matthijahn/8BitComputer/README.md

# 8BitComputer

This projects aims to build an 8-bit computer for educational purpurses

you will find the files for the seperate componst as KiCad filles as well as simulation data for each component

I want to implement an own machinecode and an asambler
