matthijahn/8BitComputer/InstructionRegister/InstructionRegister.kicad_pcb

## KiCad design InstructionRegister/InstructionRegister.kicad_pcb (2023-03-05)

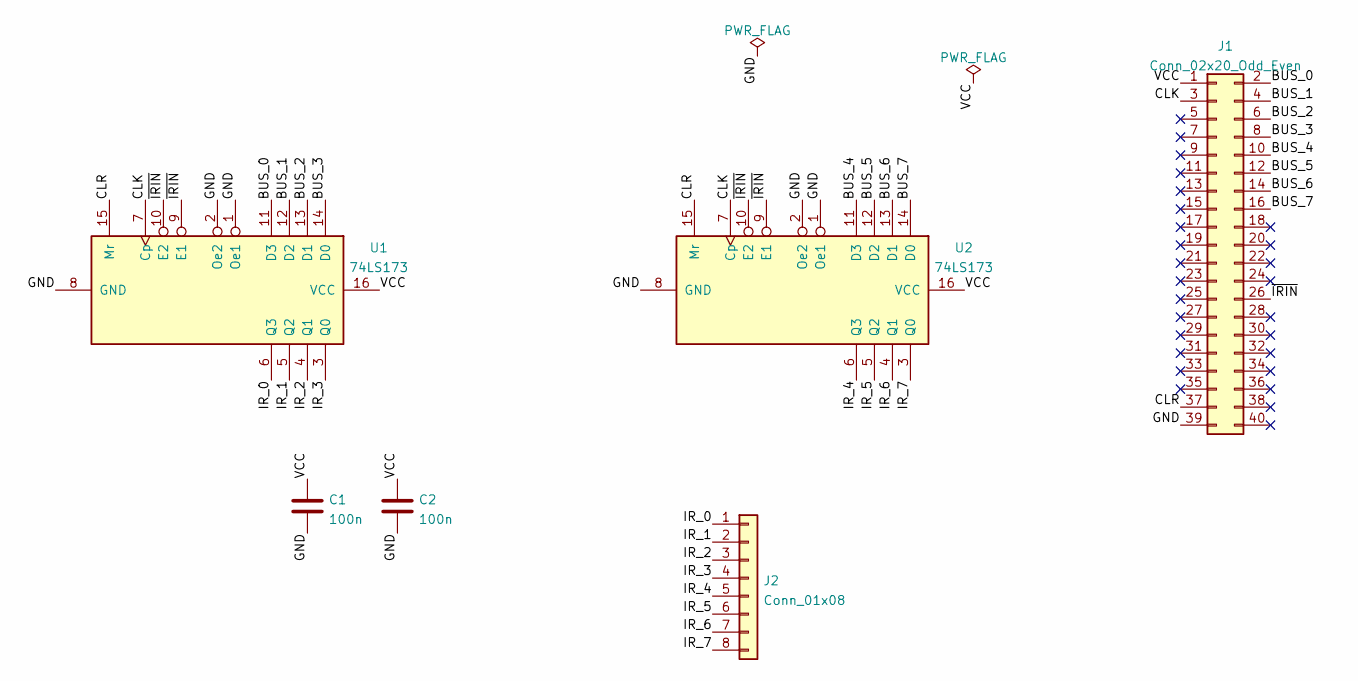
[picture p1: schematic InstructionRegister.kicad_sch]

Parts:
C1, C2: 100n; C_Disc_D5.0mm_W2.5mm_P5.00mm
J1: Conn_02x20_Odd_Even; PinSocket_2x20_P2.54mm_Horizontal
J2: Conn_01x08; PinHeader_1x08_P2.54mm_Horizontal
U1, U2: 74LS173; DIP-16_W7.62mm_LongPads

Connections:
/BUS_0: J1.2, U1.11 (D3)
/BUS_1: J1.4, U1.12 (D2)
/BUS_2: J1.6, U1.13 (D1)
/BUS_3: J1.8, U1.14 (D0)
/BUS_4: J1.10, U2.11 (D3)
/BUS_5: J1.12, U2.12 (D2)
/BUS_6: J1.14, U2.13 (D1)
/BUS_7: J1.16, U2.14 (D0)
/CLK: J1.3, U1.7 (Cp), U2.7 (Cp)
/CLR: J1.37, U1.15 (Mr), U2.15 (Mr)
/GND: C1.2, C2.2, J1.39, U1.1 (Oe1), U1.2 (Oe2), U1.8 (GND), U2.1 (Oe1), U2.2 (Oe2), U2.8 (GND)
/IR_0: J2.1, U1.6 (Q3)
/IR_1: J2.2, U1.5 (Q2)
/IR_2: J2.3, U1.4 (Q1)
/IR_3: J2.4, U1.3 (Q0)
/IR_4: J2.5, U2.6 (Q3)
/IR_5: J2.6, U2.5 (Q2)
/IR_6: J2.7, U2.4 (Q1)
/IR_7: J2.8, U2.3 (Q0)
/VCC: C1.1, C2.1, J1.1, U1.16 (VCC), U2.16 (VCC)
/~IRIN: J1.26, U1.9 (E1), U1.10 (E2), U2.9 (E1), U2.10 (E2)

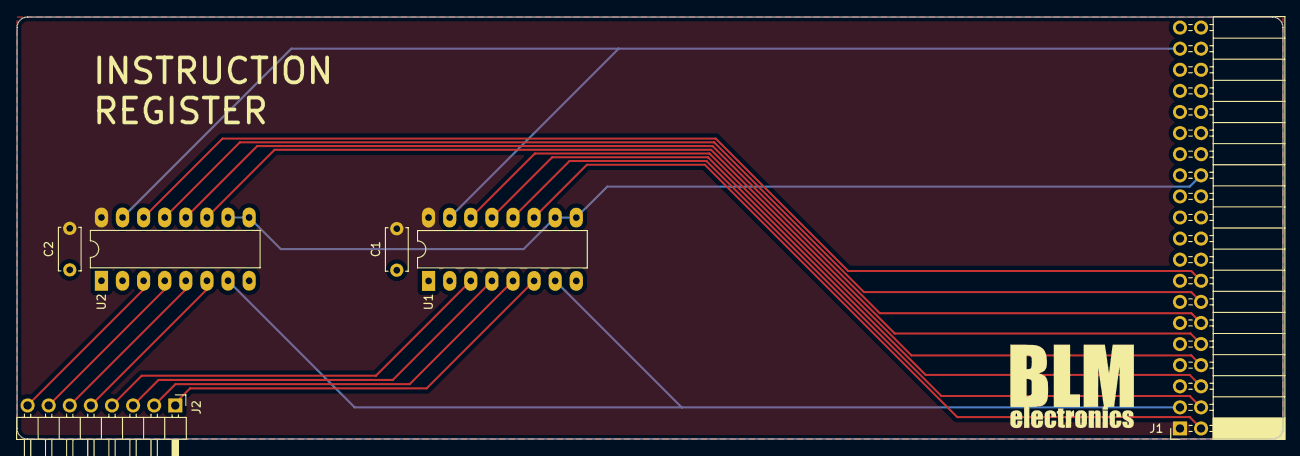
[picture p2: board InstructionRegister.kicad_pcb from above]

Board: 2 copper layers, 152.4 x 50.8 mm, 6 parts (0 on the bottom side), 21 nets.
