matthijahn/8BitComputer/PC/ProgrammCounter.kicad_pcb

## KiCad design PC/ProgrammCounter.kicad_pcb (2023-03-05)

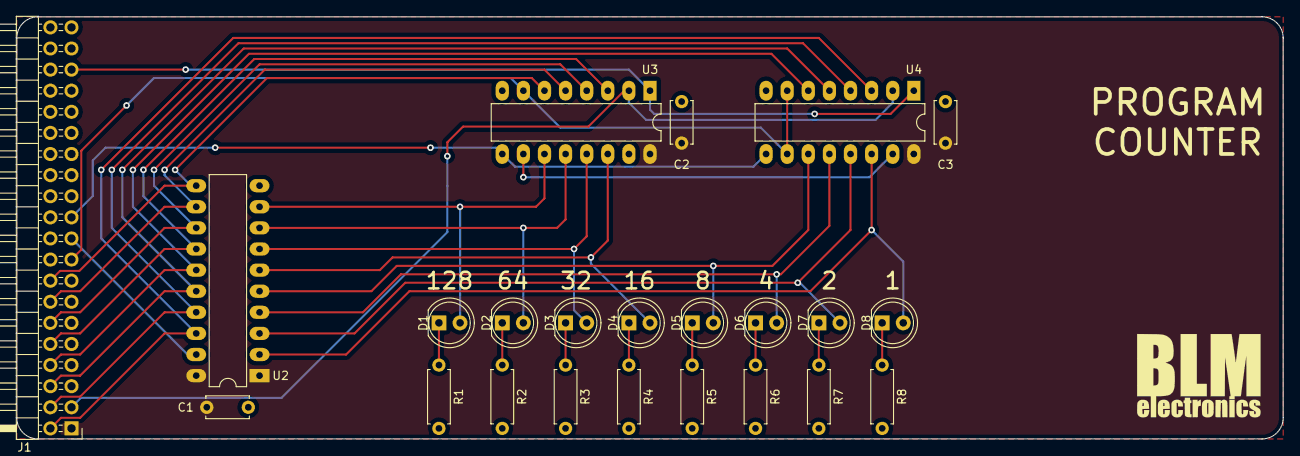
[picture p3: board ProgrammCounter.kicad_pcb from above]

Board: 2 copper layers, 152.4 x 50.8 mm, 23 parts (0 on the bottom side), 32 nets.

Parts:
C1, C2, C3: 100n; C_Disc_D5.0mm_W2.5mm_P5.00mm
D1, D2, D3, D4, D5, D6, D7, D8: LED; LED_D5.0mm
J1: Conn_02x20_Odd_Even; PinHeader_2x20_P2.54mm_Horizontal
R1, R2, R3, R4, R5, R6, R7, R8: R; R_Axial_DIN0207_L6.3mm_D2.5mm_P7.62mm_Horizontal
U2: 74HC245; DIP-20_W7.62mm_LongPads
U3, U4: 74LS161; DIP-16_W7.62mm_LongPads

Connections:
/BUS_0: J1.2, U2.18, U4.3
/BUS_1: J1.4, U2.17, U4.4
/BUS_2: J1.6, U2.16, U4.5
/BUS_3: J1.8, U2.15, U4.6
/BUS_4: J1.10, U2.14, U3.3
/BUS_5: J1.12, U2.13, U3.4
/BUS_6: J1.14, U2.12, U3.5
/BUS_7: J1.16, U2.11, U3.6
/CLK: J1.3, U3.2, U4.2
/GND: C1.2, C2.2, C3.2, J1.39, R1.2, R2.2, R3.2, R4.2, R5.2, R6.2, R7.2, R8.2, U2.10, U3.8, U4.8
/PCUP: J1.17, U3.7, U4.7, U4.10
/VCC: C1.1, C2.1, C3.1, J1.1, U2.1, U2.20, U3.16, U4.16
/~CLR: J1.35, U3.1, U4.1
/~PCIN: J1.21, U3.9, U4.9
/~PCOUT: J1.19, U2.19
unnamed: D1.1, R1.1
unnamed: D1.2, U2.9, U3.11
unnamed: D2.1, R2.1
unnamed: D2.2, U2.8, U3.12
unnamed: D3.1, R3.1
unnamed: D3.2, U2.7, U3.13
unnamed: D4.1, R4.1
unnamed: D4.2, U2.6, U3.14
unnamed: D5.1, R5.1
unnamed: D5.2, U2.5, U4.11
unnamed: D6.1, R6.1
unnamed: D6.2, U2.4, U4.12
unnamed: D7.1, R7.1
unnamed: D7.2, U2.3, U4.13
unnamed: D8.1, R8.1
unnamed: D8.2, U2.2, U4.14
unnamed: U3.10, U4.15
