matthijahn/8BitComputer/BUS/bus.kicad_pcb

## KiCad design BUS/bus.kicad_pcb (2023-03-05)

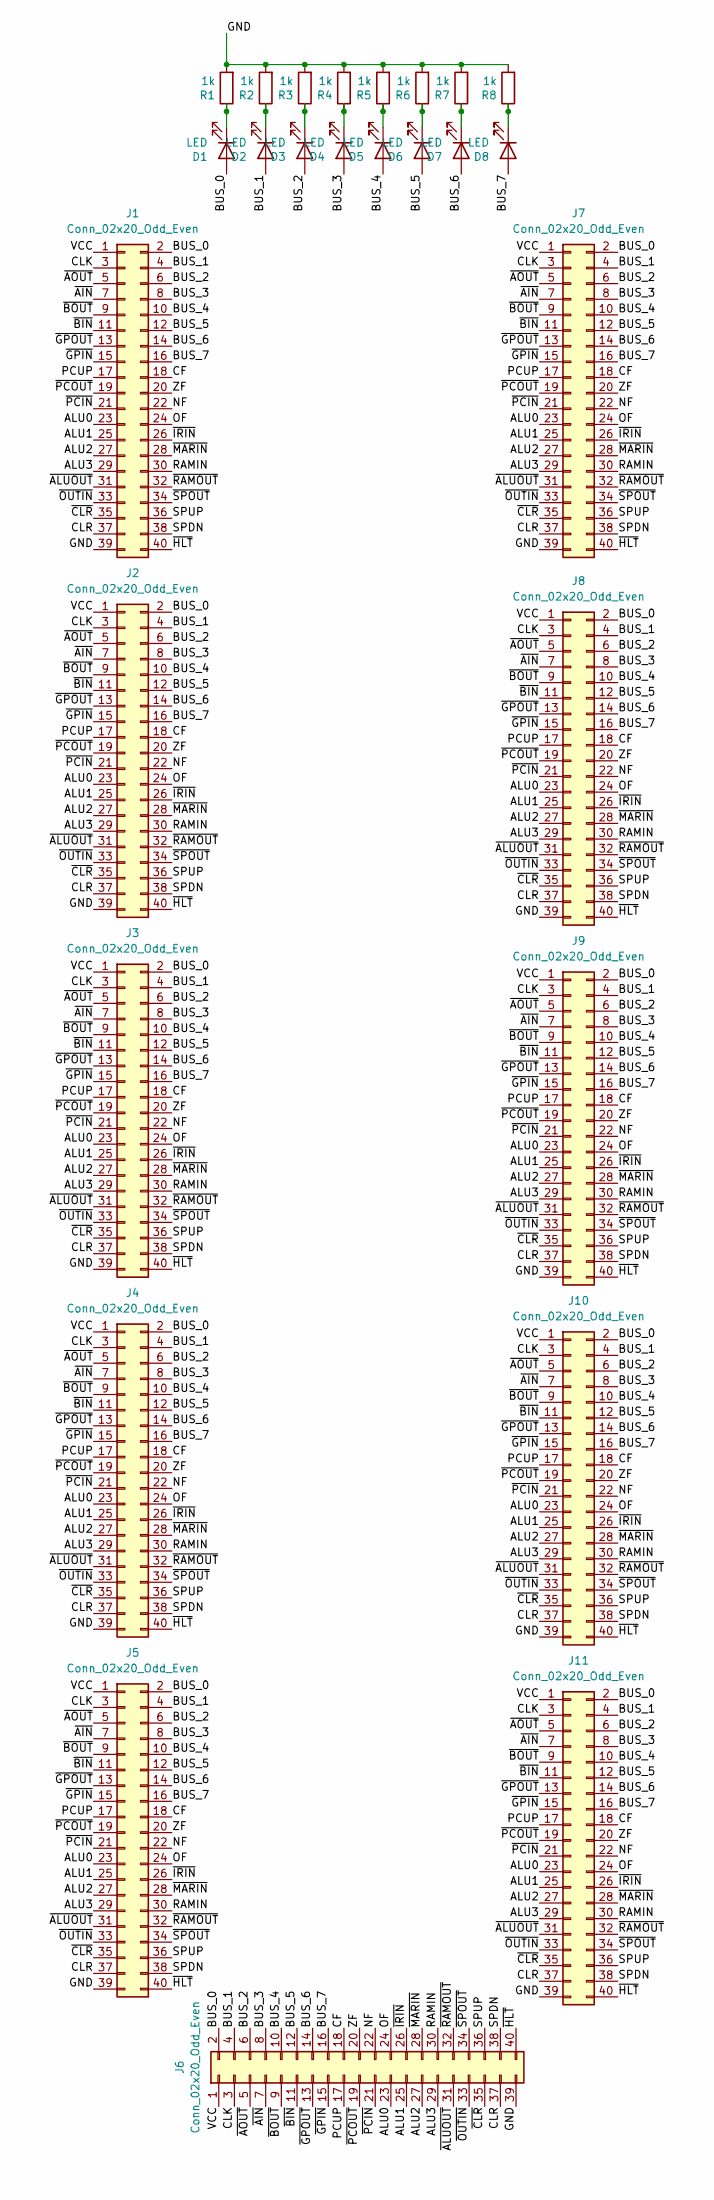
[picture p4: schematic bus.kicad_sch]

Parts:
D1, D2, D3, D4, D5, D6, D7, D8: LED; LED_D5.0mm
J1, J2, J3, J4, J5, J6: Conn_02x20_Odd_Even; PinHeader_2x20_P2.54mm_Horizontal
J7, J8, J9, J10, J11: Conn_02x20_Odd_Even; PinSocket_2x20_P2.54mm_Horizontal
R1, R2, R3, R4, R5, R6, R7, R8: 1k; R_Axial_DIN0207_L6.3mm_D2.5mm_P7.62mm_Horizontal

Connections:
/ALU0: J1.23, J2.23, J3.23, J4.23, J5.23, J6.23, J7.23, J8.23, J9.23, J10.23, J11.23
/ALU1: J1.25, J2.25, J3.25, J4.25, J5.25, J6.25, J7.25, J8.25, J9.25, J10.25, J11.25
/ALU2: J1.27, J2.27, J3.27, J4.27, J5.27, J6.27, J7.27, J8.27, J9.27, J10.27, J11.27
/ALU3: J1.29, J2.29, J3.29, J4.29, J5.29, J6.29, J7.29, J8.29, J9.29, J10.29, J11.29
/BUS_0: D1.2 (A), J1.2, J2.2, J3.2, J4.2, J5.2, J6.2, J7.2, J8.2, J9.2, J10.2, J11.2
/BUS_1: D2.2 (A), J1.4, J2.4, J3.4, J4.4, J5.4, J6.4, J7.4, J8.4, J9.4, J10.4, J11.4
/BUS_2: D3.2 (A), J1.6, J2.6, J3.6, J4.6, J5.6, J6.6, J7.6, J8.6, J9.6, J10.6, J11.6
/BUS_3: D4.2 (A), J1.8, J2.8, J3.8, J4.8, J5.8, J6.8, J7.8, J8.8, J9.8, J10.8, J11.8
/BUS_4: D5.2 (A), J1.10, J2.10, J3.10, J4.10, J5.10, J6.10, J7.10, J8.10, J9.10, J10.10, J11.10
/BUS_5: D6.2 (A), J1.12, J2.12, J3.12, J4.12, J5.12, J6.12, J7.12, J8.12, J9.12, J10.12, J11.12
/BUS_6: D7.2 (A), J1.14, J2.14, J3.14, J4.14, J5.14, J6.14, J7.14, J8.14, J9.14, J10.14, J11.14
/BUS_7: D8.2 (A), J1.16, J2.16, J3.16, J4.16, J5.16, J6.16, J7.16, J8.16, J9.16, J10.16, J11.16
/CF: J1.18, J2.18, J3.18, J4.18, J5.18, J6.18, J7.18, J8.18, J9.18, J10.18, J11.18
/CLK: J1.3, J2.3, J3.3, J4.3, J5.3, J6.3, J7.3, J8.3, J9.3, J10.3, J11.3
/CLR: J1.37, J2.37, J3.37, J4.37, J5.37, J6.37, J7.37, J8.37, J9.37, J10.37, J11.37
/GND: J1.39, J2.39, J3.39, J4.39, J5.39, J6.39, J7.39, J8.39, J9.39, J10.39, J11.39, R1.2, R2.2, R3.2, R4.2, R5.2, R6.2, R7.2, R8.2
/NF: J1.22, J2.22, J3.22, J4.22, J5.22, J6.22, J7.22, J8.22, J9.22, J10.22, J11.22
/OF: J1.24, J2.24, J3.24, J4.24, J5.24, J6.24, J7.24, J8.24, J9.24, J10.24, J11.24
/PCUP: J1.17, J2.17, J3.17, J4.17, J5.17, J6.17, J7.17, J8.17, J9.17, J10.17, J11.17
/RAMIN: J1.30, J2.30, J3.30, J4.30, J5.30, J6.30, J7.30, J8.30, J9.30, J10.30, J11.30
/SPDN: J1.38, J2.38, J3.38, J4.38, J5.38, J6.38, J7.38, J8.38, J9.38, J10.38, J11.38
/SPUP: J1.36, J2.36, J3.36, J4.36, J5.36, J6.36, J7.36, J8.36, J9.36, J10.36, J11.36
/VCC: J1.1, J2.1, J3.1, J4.1, J5.1, J6.1, J7.1, J8.1, J9.1, J10.1, J11.1
/ZF: J1.20, J2.20, J3.20, J4.20, J5.20, J6.20, J7.20, J8.20, J9.20, J10.20, J11.20
/~AIN: J1.7, J2.7, J3.7, J4.7, J5.7, J6.7, J7.7, J8.7, J9.7, J10.7, J11.7
/~ALUOUT: J1.31, J2.31, J3.31, J4.31, J5.31, J6.31, J7.31, J8.31, J9.31, J10.31, J11.31
/~AOUT: J1.5, J2.5, J3.5, J4.5, J5.5, J6.5, J7.5, J8.5, J9.5, J10.5, J11.5
/~BIN: J1.11, J2.11, J3.11, J4.11, J5.11, J6.11, J7.11, J8.11, J9.11, J10.11, J11.11
/~BOUT: J1.9, J2.9, J3.9, J4.9, J5.9, J6.9, J7.9, J8.9, J9.9, J10.9, J11.9
/~CLR: J1.35, J2.35, J3.35, J4.35, J5.35, J6.35, J7.35, J8.35, J9.35, J10.35, J11.35
/~GPIN: J1.15, J2.15, J3.15, J4.15, J5.15, J6.15, J7.15, J8.15, J9.15, J10.15, J11.15
/~GPOUT: J1.13, J2.13, J3.13, J4.13, J5.13, J6.13, J7.13, J8.13, J9.13, J10.13, J11.13
/~HLT: J1.40, J2.40, J3.40, J4.40, J5.40, J6.40, J7.40, J8.40, J9.40, J10.40, J11.40
/~IRIN: J1.26, J2.26, J3.26, J4.26, J5.26, J6.26, J7.26, J8.26, J9.26, J10.26, J11.26
/~MARIN: J1.28, J2.28, J3.28, J4.28, J5.28, J6.28, J7.28, J8.28, J9.28, J10.28, J11.28
/~OUTIN: J1.33, J2.33, J3.33, J4.33, J5.33, J6.33, J7.33, J8.33, J9.33, J10.33, J11.33
/~PCIN: J1.21, J2.21, J3.21, J4.21, J5.21, J6.21, J7.21, J8.21, J9.21, J10.21, J11.21
/~PCOUT: J1.19, J2.19, J3.19, J4.19, J5.19, J6.19, J7.19, J8.19, J9.19, J10.19, J11.19
/~RAMOUT: J1.32, J2.32, J3.32, J4.32, J5.32, J6.32, J7.32, J8.32, J9.32, J10.32, J11.32
/~SPOUT: J1.34, J2.34, J3.34, J4.34, J5.34, J6.34, J7.34, J8.34, J9.34, J10.34, J11.34
unnamed: D1.1 (K), R1.1
unnamed: D2.1 (K), R2.1
unnamed: D3.1 (K), R3.1
unnamed: D4.1 (K), R4.1
unnamed: D5.1 (K), R5.1
unnamed: D6.1 (K), R6.1
unnamed: D7.1 (K), R7.1
unnamed: D8.1 (K), R8.1

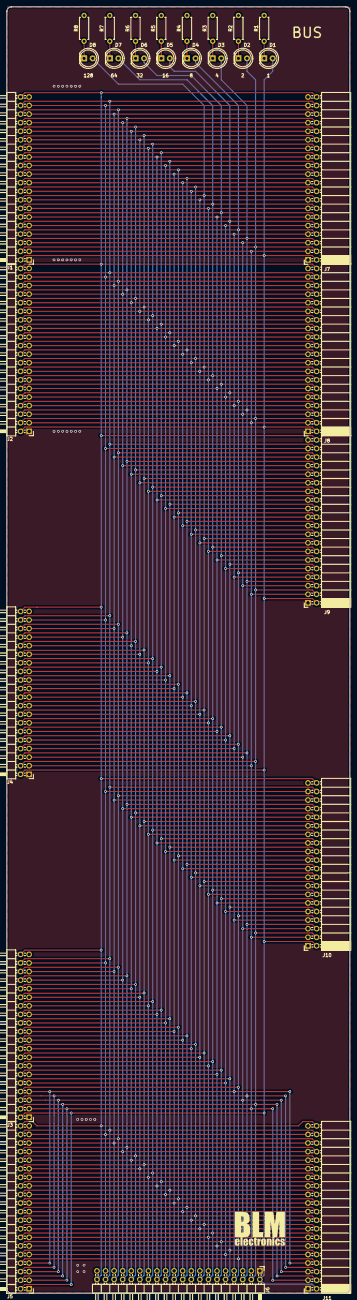
[picture p5: board bus.kicad_pcb from above]

Board: 2 copper layers, 101.6 x 381.0 mm, 27 parts (0 on the bottom side), 48 nets.
