matthijahn/8BitComputer/ALU/ALU.kicad_pcb

## KiCad design ALU/ALU.kicad_pcb (2023-03-05)

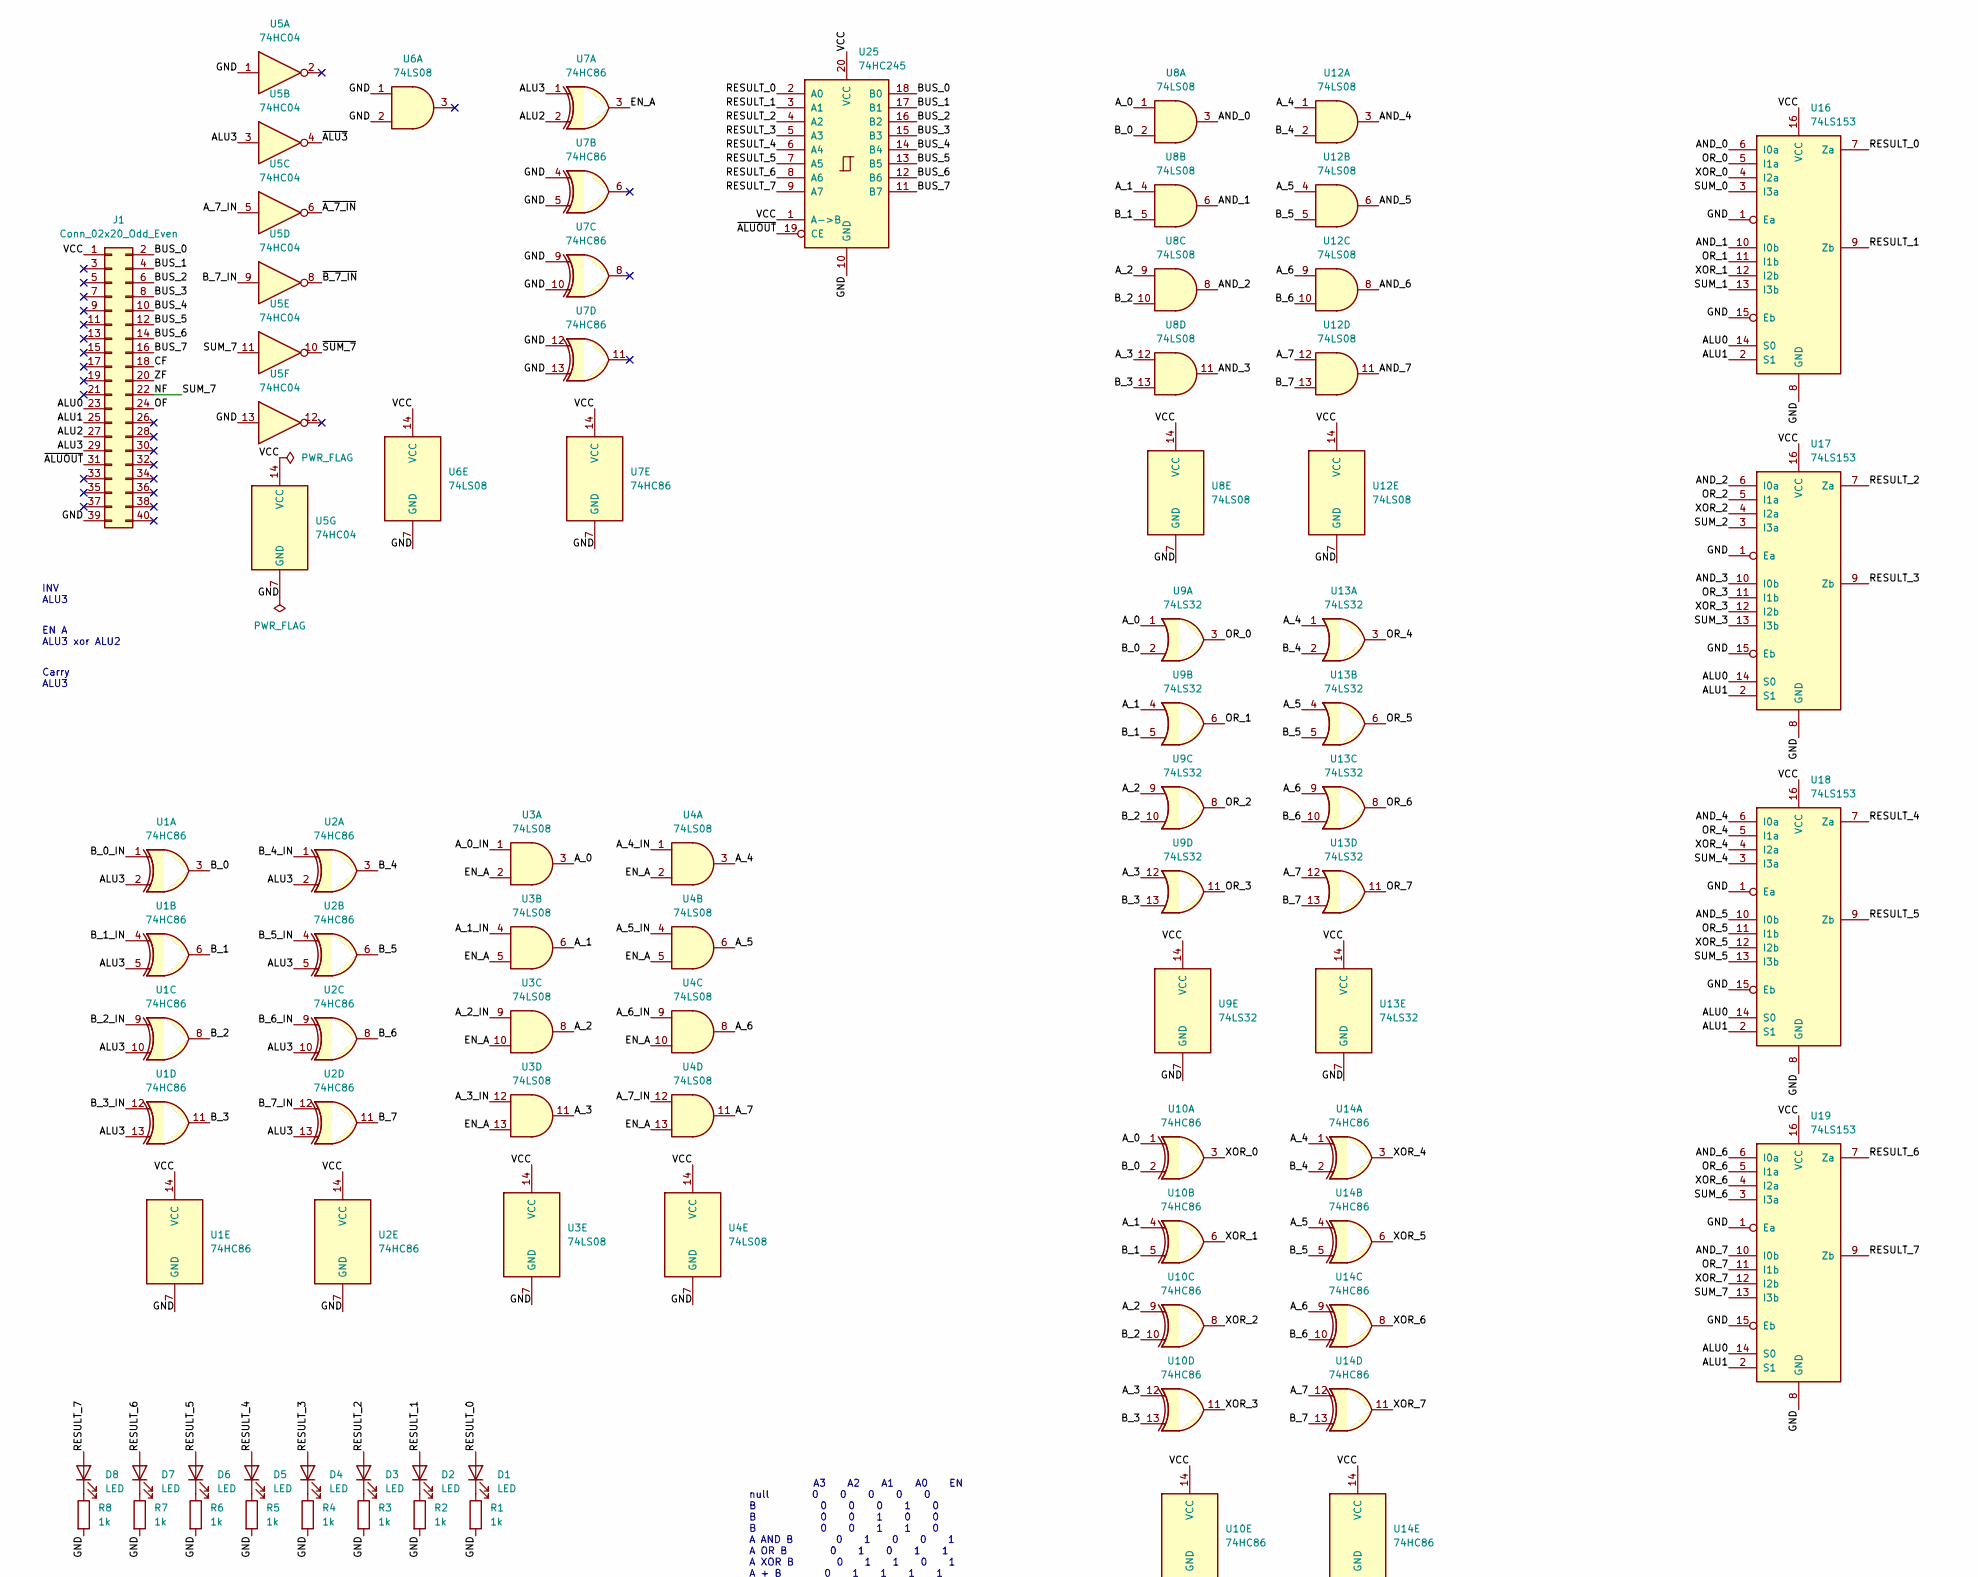
[picture p6: schematic ALU.kicad_sch, part in row 1, column 1]

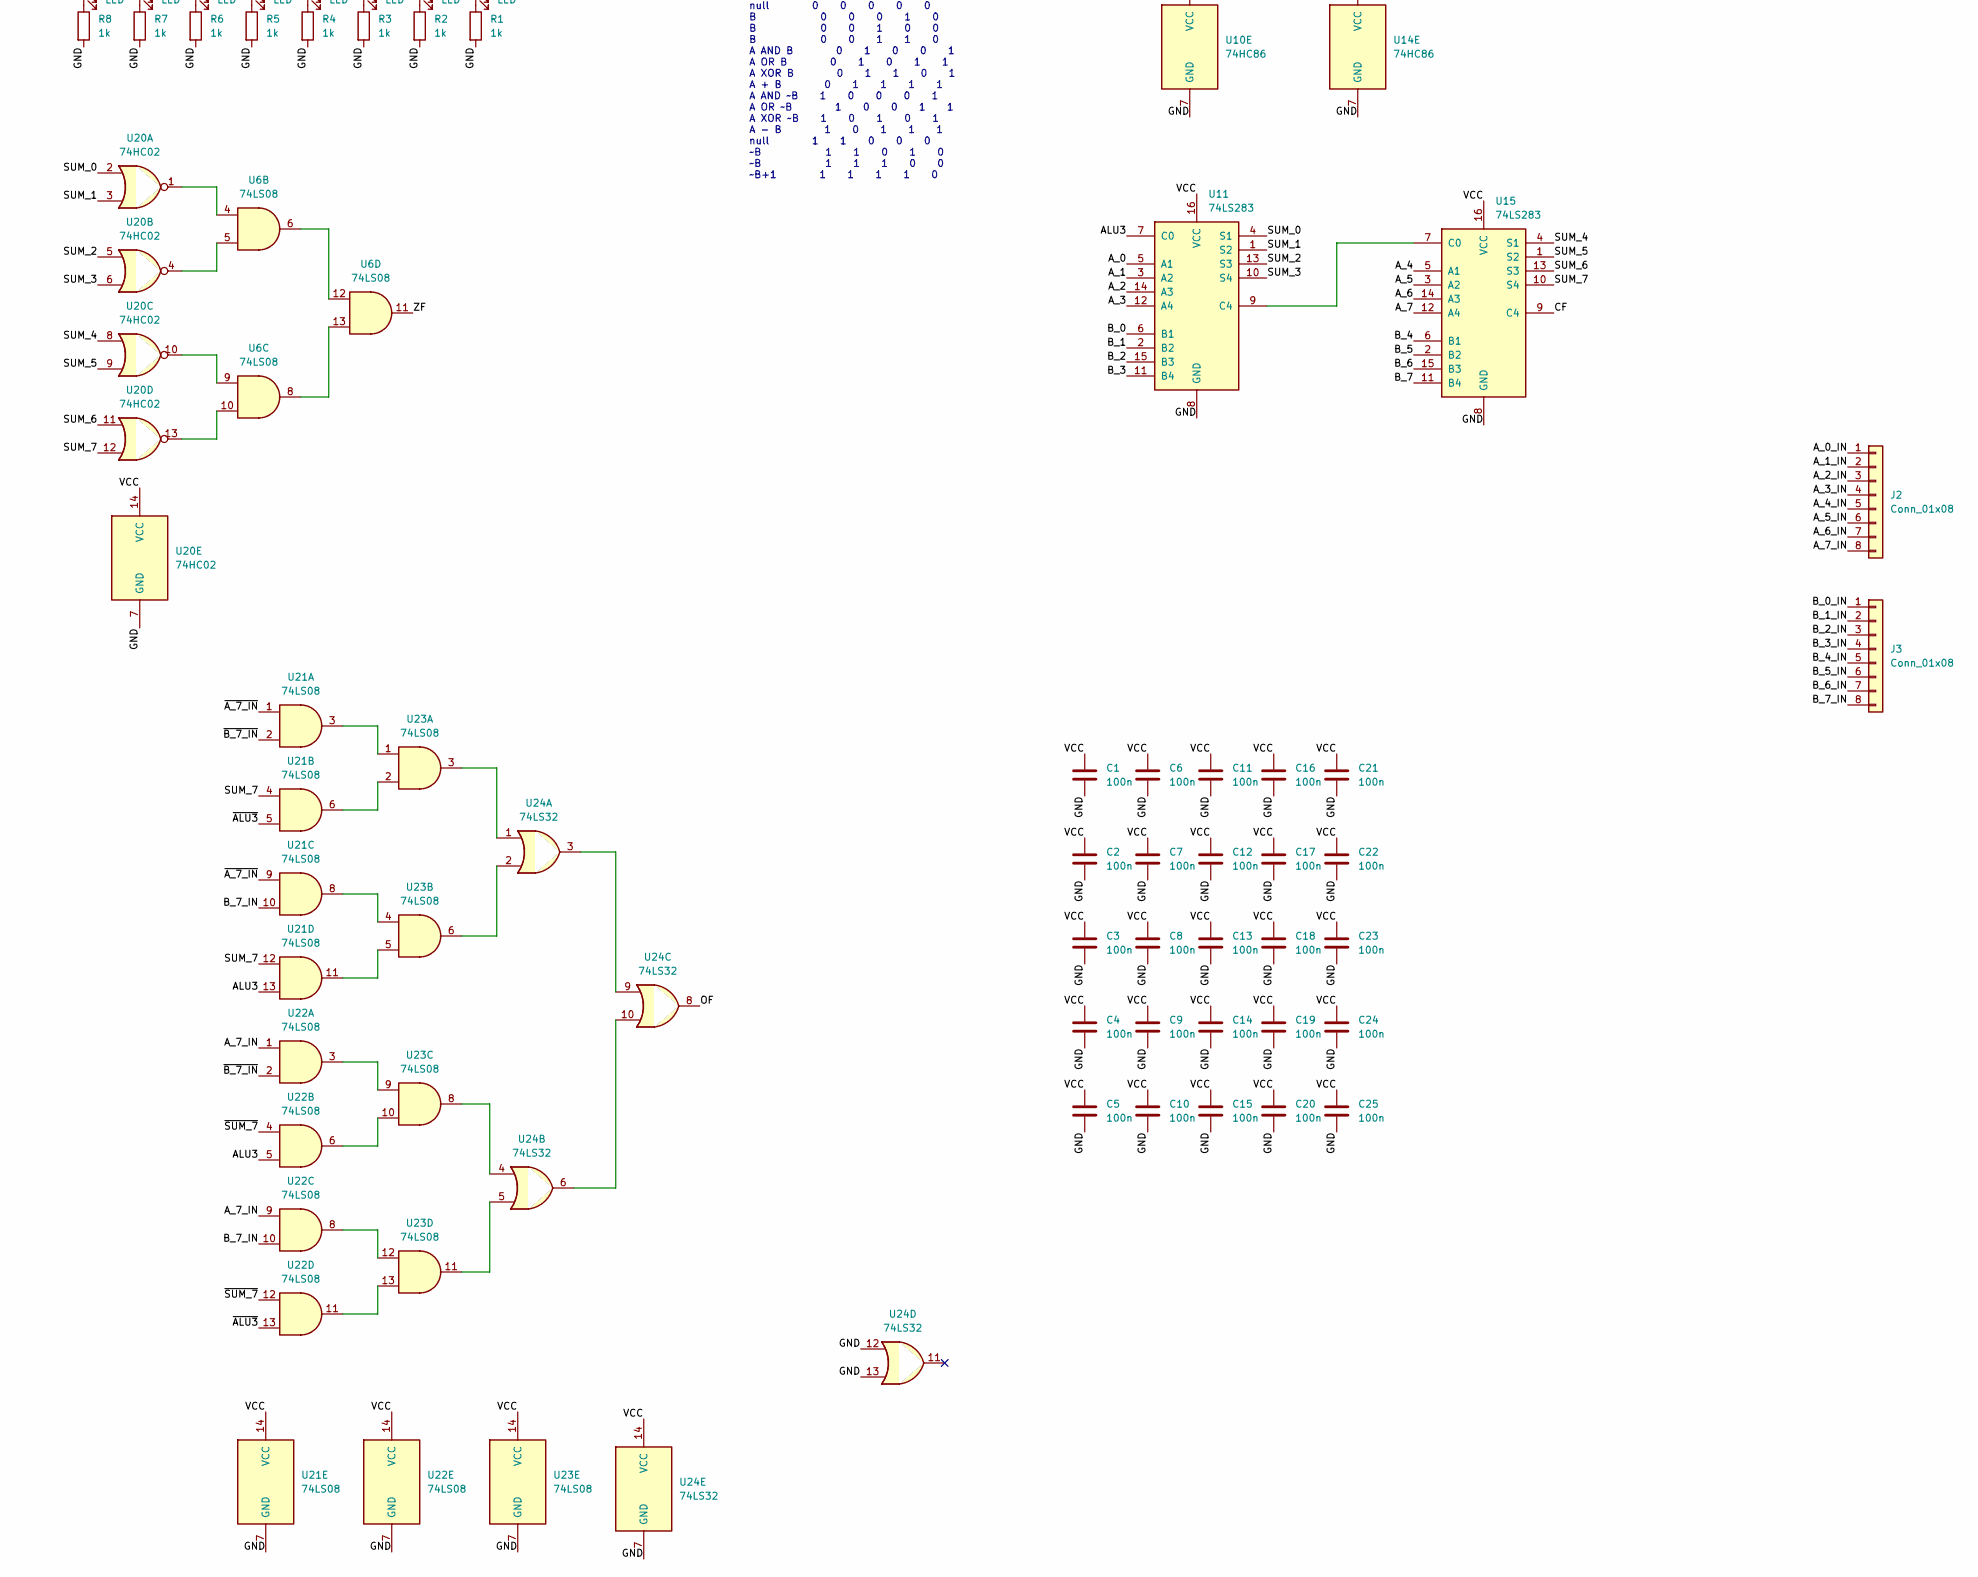
[picture p7: schematic ALU.kicad_sch, part in row 2, column 1]

Parts:
C1, C2, C3, C4, C5, C6, C7, C8, C9, C10, C11, C12, C13, C14, C15, C16, C17, C18, C19, C20, C21, C22, C23, C24, C25: 100n; C_Disc_D5.0mm_W2.5mm_P5.00mm
D1, D2, D3, D4, D5, D6, D7, D8: LED; LED_D5.0mm
J1: Conn_02x20_Odd_Even; PinHeader_2x20_P2.54mm_Horizontal
J2, J3: Conn_01x08; PinSocket_1x08_P2.54mm_Horizontal
R1, R2, R3, R4, R5, R6, R7, R8: 1k; R_Axial_DIN0207_L6.3mm_D2.5mm_P7.62mm_Horizontal
U1, U2, U7, U10, U14: 74HC86; DIP-14_W7.62mm_LongPads
U3, U4, U6, U8, U12, U21, U22, U23: 74LS08; DIP-14_W7.62mm_LongPads
U5: 74HC04; DIP-14_W7.62mm_LongPads
U9, U13, U24: 74LS32; DIP-14_W7.62mm_LongPads
U11, U15: 74LS283; DIP-16_W7.62mm_LongPads
U16, U17, U18, U19: 74LS153; DIP-16_W7.62mm_LongPads
U20: 74HC02; DIP-14_W7.62mm_LongPads
U25: 74HC245; DIP-20_W7.62mm_LongPads

Connections:
/ALU0: J1.23, U16.14 (S0), U17.14 (S0), U18.14 (S0), U19.14 (S0)
/ALU1: J1.25, U16.2 (S1), U17.2 (S1), U18.2 (S1), U19.2 (S1)
/ALU2: J1.27, U7.2
/ALU3: J1.29, U1.2, U1.5, U1.10, U1.13, U2.2, U2.5, U2.10, U2.13, U5.3, U7.1, U11.7 (C0), U21.13, U22.5
/AND_0: U8.3, U16.6 (I0a)
/AND_1: U8.6, U16.10 (I0b)
/AND_2: U8.8, U17.6 (I0a)
/AND_3: U8.11, U17.10 (I0b)
/AND_4: U12.3, U18.6 (I0a)
/AND_5: U12.6, U18.10 (I0b)
/AND_6: U12.8, U19.6 (I0a)
/AND_7: U12.11, U19.10 (I0b)
/A_0: U3.3, U8.1, U9.1, U10.1, U11.5 (A1)
/A_0_IN: J2.1, U3.1
/A_1: U3.6, U8.4, U9.4, U10.4, U11.3 (A2)
/A_1_IN: J2.2, U3.4
/A_2: U3.8, U8.9, U9.9, U10.9, U11.14 (A3)
/A_2_IN: J2.3, U3.9
/A_3: U3.11, U8.12, U9.12, U10.12, U11.12 (A4)
/A_3_IN: J2.4, U3.12
/A_4: U4.3, U12.1, U13.1, U14.1, U15.5 (A1)
/A_4_IN: J2.5, U4.1
/A_5: U4.6, U12.4, U13.4, U14.4, U15.3 (A2)
/A_5_IN: J2.6, U4.4
/A_6: U4.8, U12.9, U13.9, U14.9, U15.14 (A3)
/A_6_IN: J2.7, U4.9
/A_7: U4.11, U12.12, U13.12, U14.12, U15.12 (A4)
/A_7_IN: J2.8, U4.12, U5.5, U22.1, U22.9
/BUS_0: J1.2, U25.18 (B0)
/BUS_1: J1.4, U25.17 (B1)
/BUS_2: J1.6, U25.16 (B2)
/BUS_3: J1.8, U25.15 (B3)
/BUS_4: J1.10, U25.14 (B4)
/BUS_5: J1.12, U25.13 (B5)
/BUS_6: J1.14, U25.12 (B6)
/BUS_7: J1.16, U25.11 (B7)
/B_0: U1.3, U8.2, U9.2, U10.2, U11.6 (B1)
/B_0_IN: J3.1, U1.1
/B_1: U1.6, U8.5, U9.5, U10.5, U11.2 (B2)
/B_1_IN: J3.2, U1.4
/B_2: U1.8, U8.10, U9.10, U10.10, U11.15 (B3)
/B_2_IN: J3.3, U1.9
/B_3: U1.11, U8.13, U9.13, U10.13, U11.11 (B4)
/B_3_IN: J3.4, U1.12
/B_4: U2.3, U12.2, U13.2, U14.2, U15.6 (B1)
/B_4_IN: J3.5, U2.1
/B_5: U2.6, U12.5, U13.5, U14.5, U15.2 (B2)
/B_5_IN: J3.6, U2.4
/B_6: U2.8, U12.10, U13.10, U14.10, U15.15 (B3)
/B_6_IN: J3.7, U2.9
/B_7: U2.11, U12.13, U13.13, U14.13, U15.11 (B4)
/B_7_IN: J3.8, U2.12, U5.9, U21.10, U22.10
/CF: J1.18, U15.9 (C4)
/EN_A: U3.2, U3.5, U3.10, U3.13, U4.2, U4.5, U4.10, U4.13, U7.3
/GND: C1.2, C2.2, C3.2, C4.2, C5.2, C6.2, C7.2, C8.2, C9.2, C10.2, C11.2, C12.2, C13.2, C14.2, C15.2, C16.2, C17.2, C18.2, C19.2, C20.2, C21.2, C22.2, C23.2, C24.2, C25.2, J1.39, R1.2, R2.2, R3.2, R4.2, R5.2, R6.2, R7.2, R8.2, U1.7 (GND), U2.7 (GND), U3.7 (GND), U4.7 (GND), U5.1, U5.7 (GND), U5.13, U6.1, U6.2, U6.7 (GND), U7.4, U7.5, U7.7 (GND), U7.9, U7.10, U7.12, U7.13, U8.7 (GND), U9.7 (GND), U10.7 (GND), U11.8 (GND), U12.7 (GND), U13.7 (GND), U14.7 (GND), U15.8 (GND), U16.1 (Ea), U16.8 (GND), U16.15 (Eb), U17.1 (Ea), U17.8 (GND), U17.15 (Eb), U18.1 (Ea), U18.8 (GND), U18.15 (Eb), U19.1 (Ea), U19.8 (GND), U19.15 (Eb), U20.7 (GND), U21.7 (GND), U22.7 (GND), U23.7 (GND), U24.7 (GND), U24.12, U24.13, U25.10 (GND)
/NF: J1.22, U5.11, U15.10 (S4), U19.13 (I3b), U20.12, U21.4, U21.12
/OF: J1.24, U24.8
/OR_0: U9.3, U16.5 (I1a)
/OR_1: U9.6, U16.11 (I1b)
/OR_2: U9.8, U17.5 (I1a)
/OR_3: U9.11, U17.11 (I1b)
/OR_4: U13.3, U18.5 (I1a)
/OR_5: U13.6, U18.11 (I1b)
/OR_6: U13.8, U19.5 (I1a)
/OR_7: U13.11, U19.11 (I1b)
/RESULT_0: D1.2 (A), U16.7 (Za), U25.2 (A0)
/RESULT_1: D2.2 (A), U16.9 (Zb), U25.3 (A1)
/RESULT_2: D3.2 (A), U17.7 (Za), U25.4 (A2)
/RESULT_3: D4.2 (A), U17.9 (Zb), U25.5 (A3)
/RESULT_4: D5.2 (A), U18.7 (Za), U25.6 (A4)
/RESULT_5: D6.2 (A), U18.9 (Zb), U25.7 (A5)
/RESULT_6: D7.2 (A), U19.7 (Za), U25.8 (A6)
/RESULT_7: D8.2 (A), U19.9 (Zb), U25.9 (A7)
/SUM_0: U11.4 (S1), U16.3 (I3a), U20.2
/SUM_1: U11.1 (S2), U16.13 (I3b), U20.3
/SUM_2: U11.13 (S3), U17.3 (I3a), U20.5
/SUM_3: U11.10 (S4), U17.13 (I3b), U20.6
/SUM_4: U15.4 (S1), U18.3 (I3a), U20.8
/SUM_5: U15.1 (S2), U18.13 (I3b), U20.9
/SUM_6: U15.13 (S3), U19.3 (I3a), U20.11
/VCC: C1.1, C2.1, C3.1, C4.1, C5.1, C6.1, C7.1, C8.1, C9.1, C10.1, C11.1, C12.1, C13.1, C14.1, C15.1, C16.1, C17.1, C18.1, C19.1, C20.1, C21.1, C22.1, C23.1, C24.1, C25.1, J1.1, U1.14 (VCC), U2.14 (VCC), U3.14 (VCC), U4.14 (VCC), U5.14 (VCC), U6.14 (VCC), U7.14 (VCC), U8.14 (VCC), U9.14 (VCC), U10.14 (VCC), U11.16 (VCC), U12.14 (VCC), U13.14 (VCC), U14.14 (VCC), U15.16 (VCC), U16.16 (VCC), U17.16 (VCC), U18.16 (VCC), U19.16 (VCC), U20.14 (VCC), U21.14 (VCC), U22.14 (VCC), U23.14 (VCC), U24.14 (VCC), U25.1 (A->B), U25.20 (VCC)
/XOR_0: U10.3, U16.4 (I2a)
/XOR_1: U10.6, U16.12 (I2b)
/XOR_2: U10.8, U17.4 (I2a)
/XOR_3: U10.11, U17.12 (I2b)
/XOR_4: U14.3, U18.4 (I2a)
/XOR_5: U14.6, U18.12 (I2b)
/XOR_6: U14.8, U19.4 (I2a)
/XOR_7: U14.11, U19.12 (I2b)
/ZF: J1.20, U6.11
/~ALU3: U5.4, U21.5, U22.13
/~ALUOUT: J1.31, U25.19 (CE)
/~A_7_IN: U5.6, U21.1, U21.9
/~B_7_IN: U5.8, U21.2, U22.2
/~SUM_7: U5.10, U22.4, U22.12
unnamed: D1.1 (K), R1.1
unnamed: D2.1 (K), R2.1
unnamed: D3.1 (K), R3.1
unnamed: D4.1 (K), R4.1
unnamed: D5.1 (K), R5.1
unnamed: D6.1 (K), R6.1
unnamed: D7.1 (K), R7.1
unnamed: D8.1 (K), R8.1
unnamed: U6.6, U6.12
unnamed: U6.8, U6.13
unnamed: U11.9 (C4), U15.7 (C0)
unnamed: U6.4, U20.1
unnamed: U6.5, U20.4
unnamed: U6.9, U20.10
unnamed: U6.10, U20.13
unnamed: U21.3, U23.1
unnamed: U21.6, U23.2
unnamed: U21.8, U23.4
unnamed: U21.11, U23.5
unnamed: U22.3, U23.9
unnamed: U22.6, U23.10
unnamed: U22.8, U23.12
unnamed: U22.11, U23.13
unnamed: U23.3, U24.1
unnamed: U23.6, U24.2
unnamed: U23.8, U24.4
unnamed: U23.11, U24.5
unnamed: U24.3, U24.9
unnamed: U24.6, U24.10

Notes on the sheet:
Carry ALU3
EN A ALU3 xor ALU2
INV ALU3
A3 A2 A1 A0 EN null 0 0 0 0 0 B 0 0 0 1 0 B 0 0 1 0 0 B 0 0 1 1 0 A AND B 0 1 0 0 1 A OR B 0 1 0 1 1 A XOR B 0 1 1 0 1 A + B 0 1 1 1 1 A AND ~B 1 0 0 0 1 A OR ~B 1 0 0 1 1 A XOR ~B 1 0 1 0 1 A - B 1 0 1 1 1 null 1 1 0 0 0 ~B 1 1 0 1 0 ~B 1 1 1 0 0 ~B+1 1 1 1 1 0

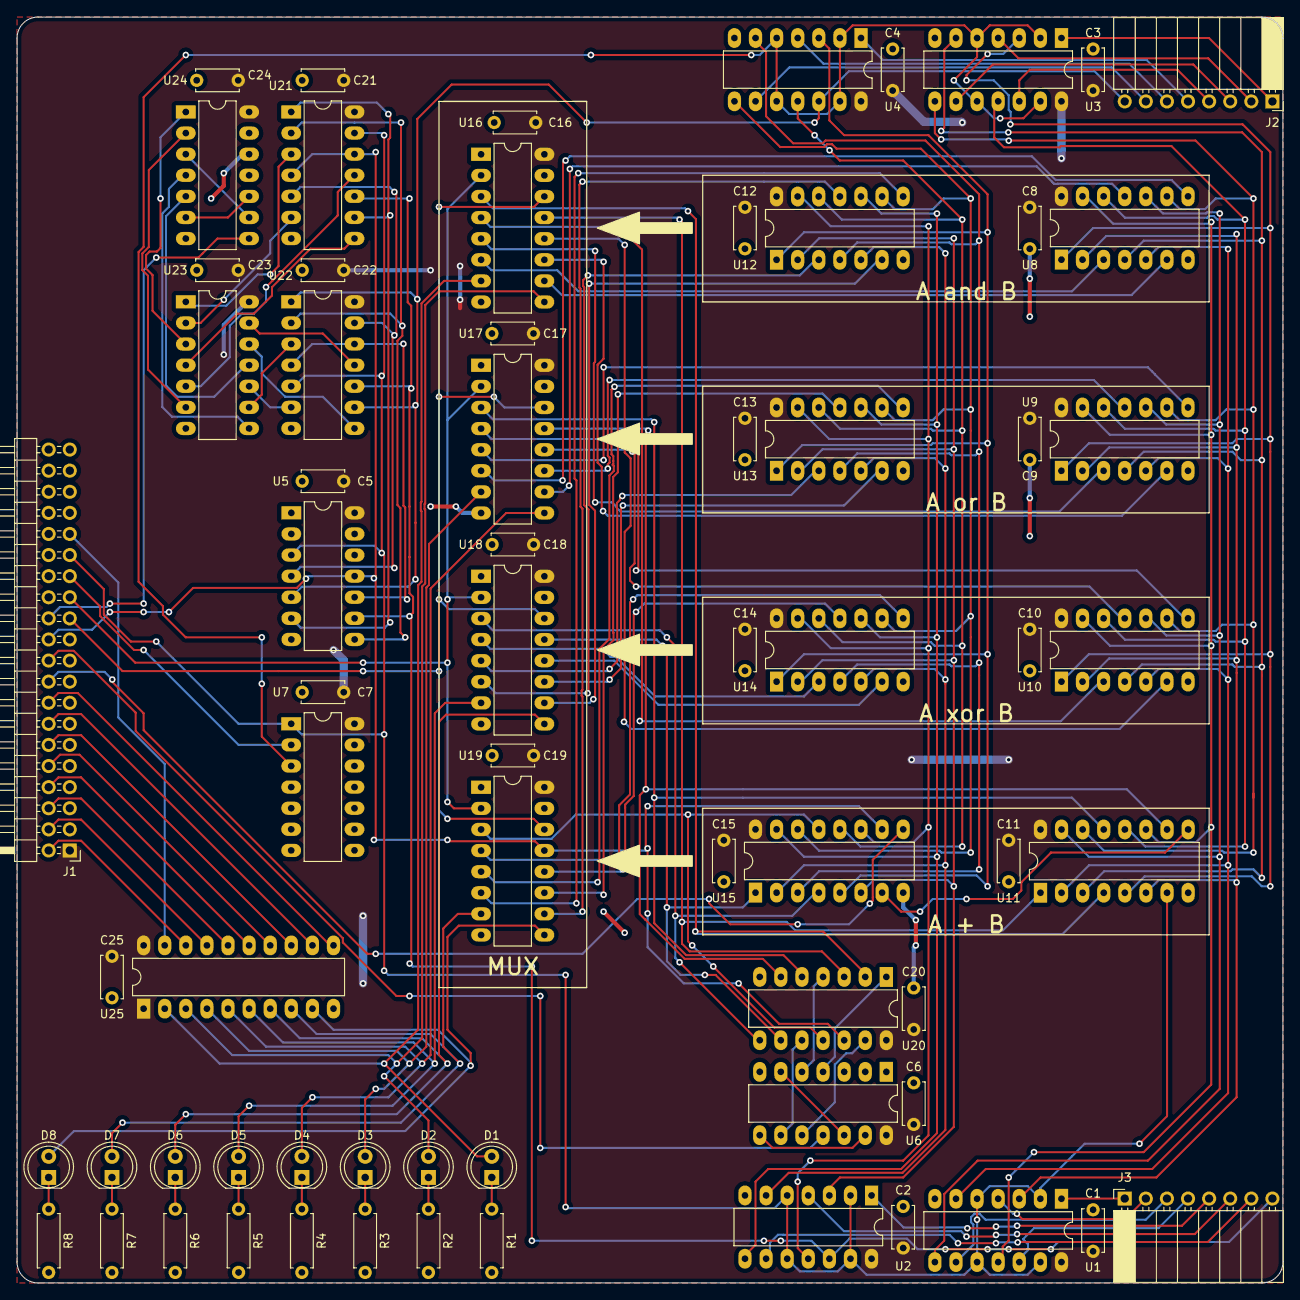
[picture p8: board ALU.kicad_pcb from above]

Board: 2 copper layers, 152.4 x 152.4 mm, 69 parts (0 on the bottom side), 124 nets.
